CJP-Whitt/Spot_Welder/README.md

# DIY Spot Welder
DIY spot welder from old microwave for making Li-ion 18650 packs with nickel strips.
Uses bluetooth communication in custom Android app to adjust welding parameters.

Video of welder in use (plus how strong welds can be): https://www.youtube.com/watch?v=DYY4uMhj9es&ab_channel=whittyman  
Photos of build progression (Google photos): https://photos.app.goo.gl/j9NsPbFjYHL5vnTS6  

# Spot Welder Controller Android Application
Android App for changing welding parameters to get ideal weld
APK Download Link V1.1 --> https://drive.google.com/file/d/1LjHpt89rQLZouo0MwVBHZ62kARO4WaJr/view?usp=sharing

# Disclaimer!
Do your research! I do not take responsibility for any issues you may encounter during your build if you attempt to make a spot welder. It is difficult and there are many roadblocks you must engineer your way through. Learning comes through failure and troubleshooting so get used to it now if you plan on doing more projects in the future.

*Project relies on SPI flash chip on board the Express M0 Board, if you want to use a different board you may have to adjust code*

# Sections
- [Components](#components)  
- [Spot Welder Build Progression](#build-progression)  
- [Spot Welder Settings App](#app-details)  
- [Arduino Firmware](#arduino-details)  

# Finished Project
### _Max Current Output: ~550 Amps, Max Current Draw: ~35 Amps, Secondary Coil Output: ~7 Volts, Primary Coil Resistance: 0.4 Ohms_

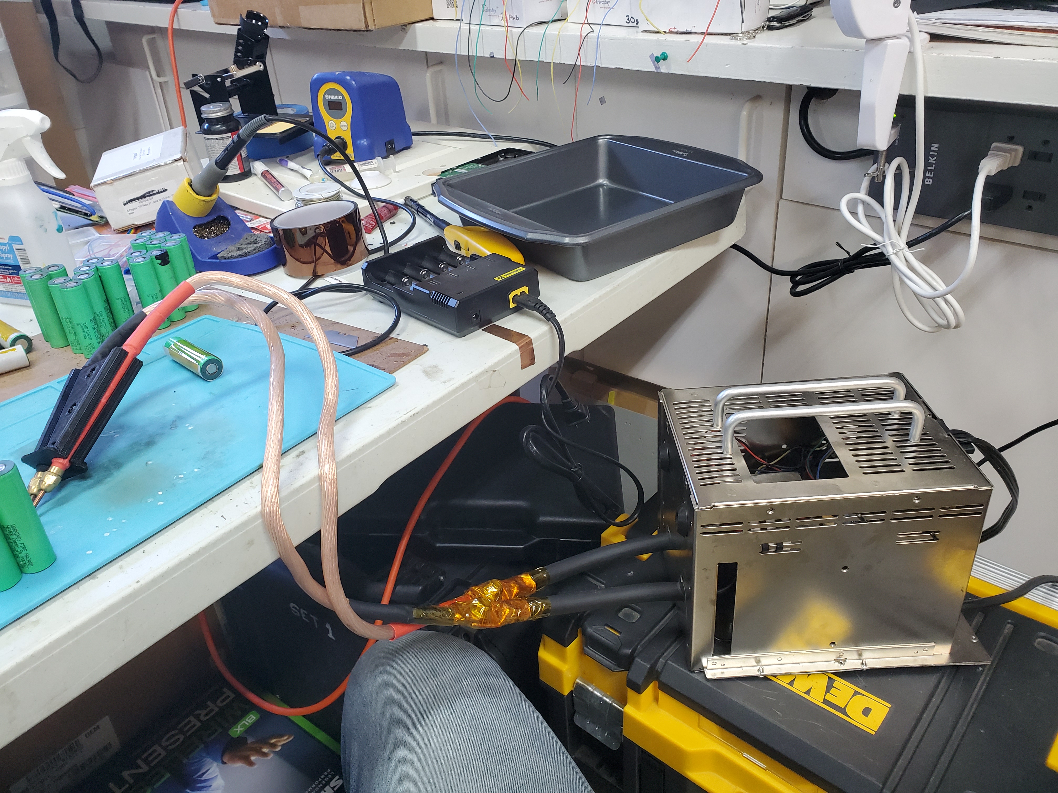
[picture p1: SpotWelder_Photos/firstUse.jpg]
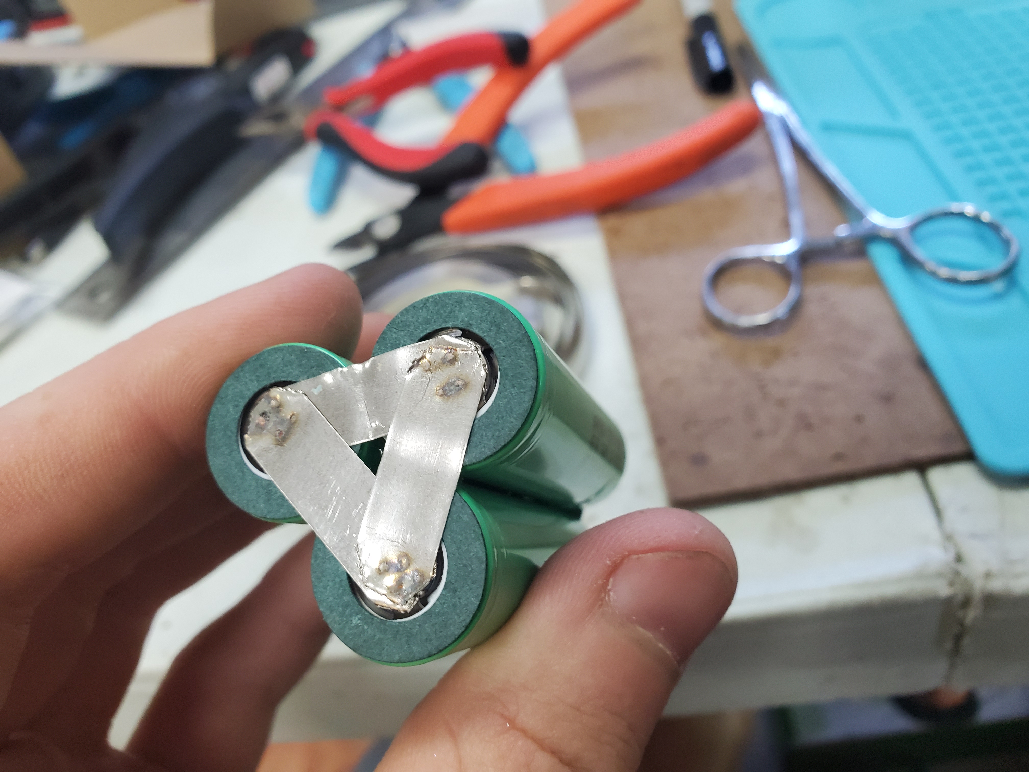
[picture p2: SpotWelder_Photos/batteryExample.jpg]
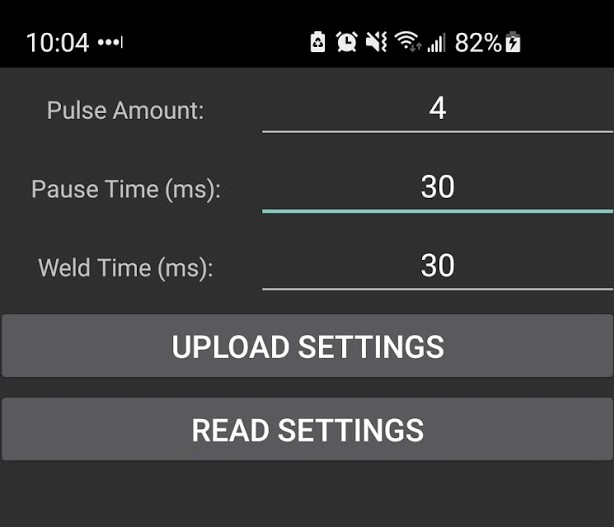
[picture p3: SpotWelder_Photos/SpotWelder_AppSettings.jpg]


## Components
1.) AC relay: https://www.amazon.com/SSR-25-DC-AC-Solid-State-Relay/dp/B07FVR37QN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  
2.) Adafruit ItsyBitsy Express M0: https://www.adafruit.com/product/3727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  
3.) Foot pedal switch:  https://www.amazon.com/URBEST-Momentary-Industrial-Anti-skid-Surface/dp/B01LXTEQ1C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  
4.) HC-05 bluetooth module: https://www.amazon.com/Wireless-Bluetooth-Receiver-Transceiver-Transmitter/dp/B01MQKX7VP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  
5.) Wall outlet usb charger (basically any work...make sure output voltage isn't too high)
6.) Microwave transformer (From my experience 750W is not enough, try to find at least a 1000W one)  
7.) Welding cable 2/0GA  
8.) Outlet plug and cable (preferably with ground wire, take from microwave you disassemble)  
9.) Welding tips: https://www.amazon.com/gp/product/B085FTFLMQ/ref=ppx_yo_dt_b_asin_title_o04_s00?ie=UTF8&psc=1  
10.) Crimp on terminal lugs  
11.) Some kind of insulation for electrical connections  

## Build Progression

### Step One: Getting the right transformer
You need a big enough transformer for this to work. My first transformer I got of 750W wasn’t powerful enough. I got another one from an old microwave that was 1000W and that one was perfect. Here you can see them side by side. Bigger one is 1000W.

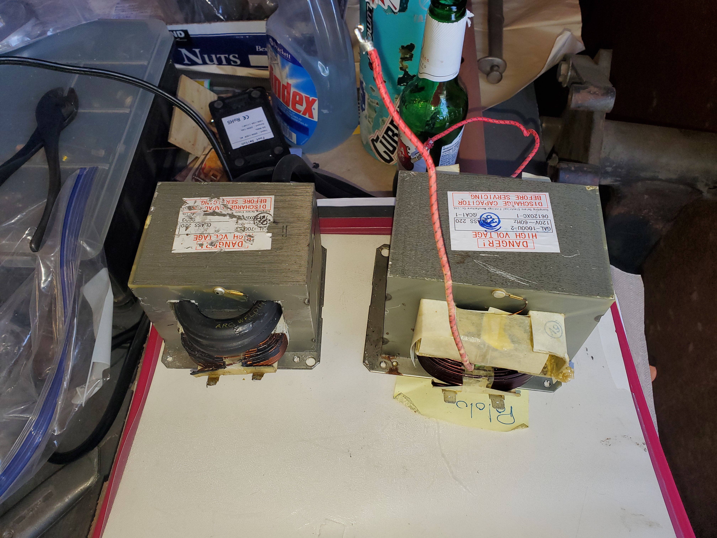
[picture p4: SpotWelder_Photos/20200905_143613.jpg]
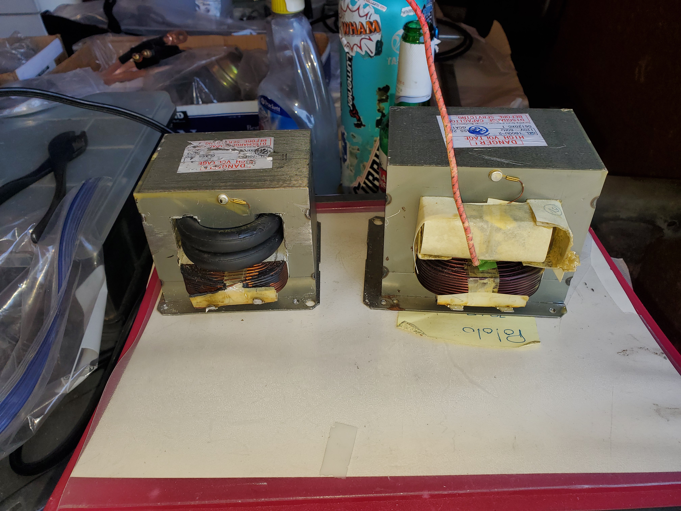
[picture p5: SpotWelder_Photos/20200905_143610.jpg]


### Step Two: Rewinding the secondary coil
To get the right output current from this transformer for spot welding (high current) I had to change the secondary coil. I cut the transformer core at the seams and took out the finer wound coil and replaced it with very very thick gauge wire, it's actually welding cable. Then I rewelded the seams and have a complete high current transformer capable of 550 Amps.

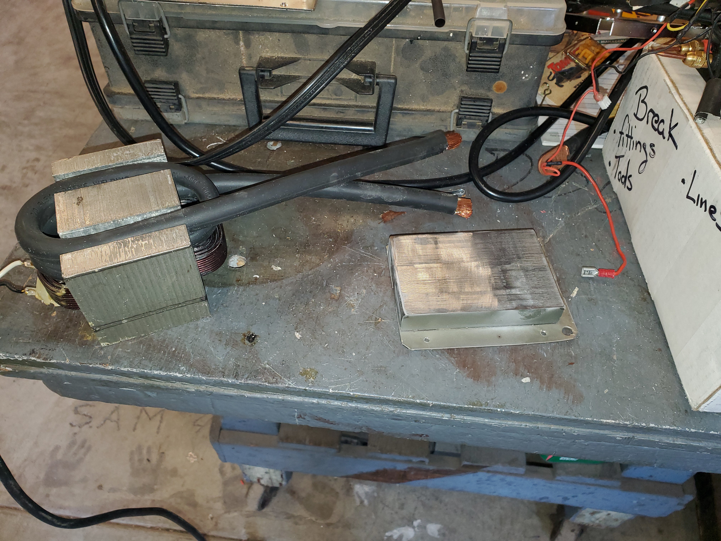
[picture p6: SpotWelder_Photos/20200912_140432.jpg]
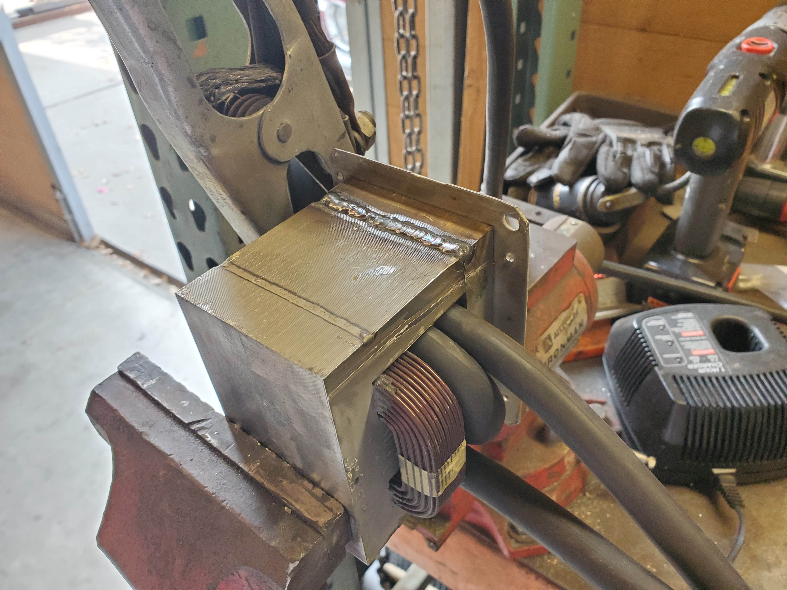
[picture p7: SpotWelder_Photos/20200912_144256.jpg]


### Step Three: Getting a shell
For the shell I used an old power supply casing for a server power supply. It worked quite nicely. I would definitely suggest having a metal casing so you can ground it and not have to worry about being electrocuted.

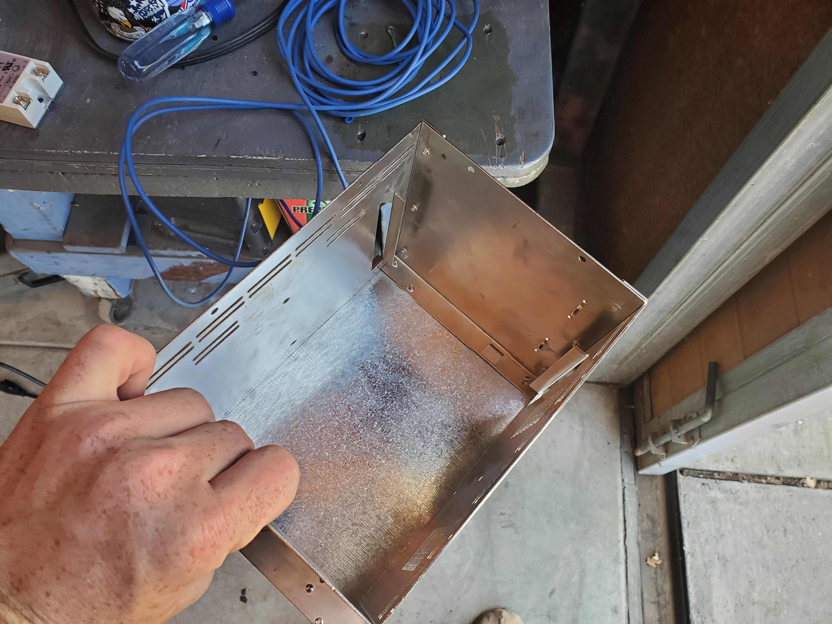
[picture p8: SpotWelder_Photos/20200725_133812.jpg]


### Step Four: Wiring and completion
Here is a amatuer wiring diagram I created along with an image of the inside of the finished Spot Welder.

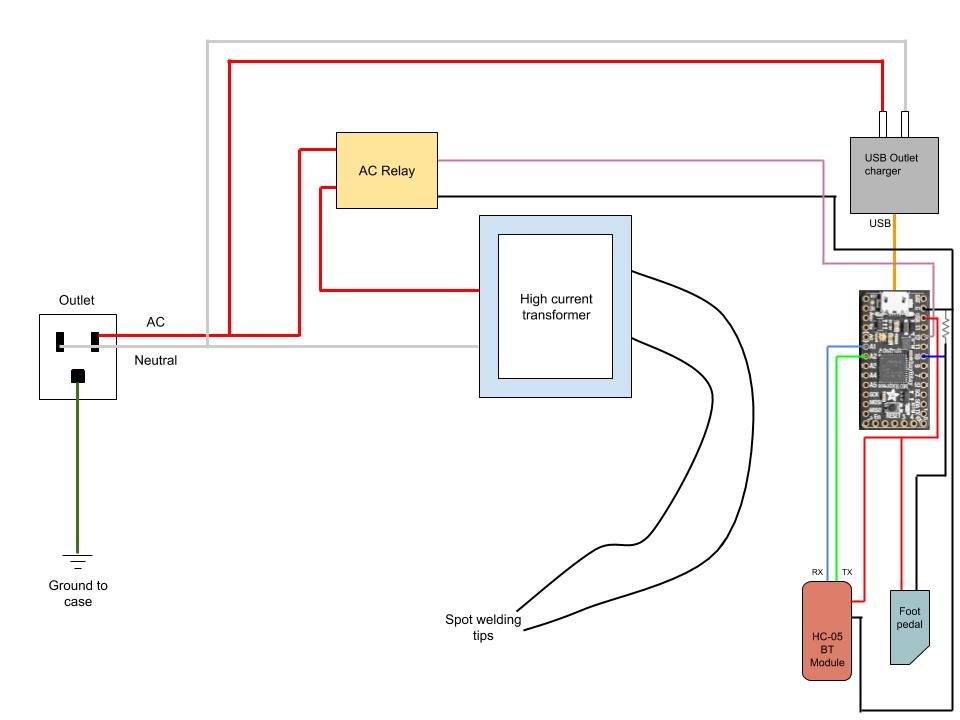
[picture p9: SpotWelder_Photos/Wiring Diagram Final.jpg]


## App Details
The app connects to the BLE module connected to the arduino. It changes settings that are saved on board the arduino. Or it can load saved settings from the arduino (happens automatically on startup).

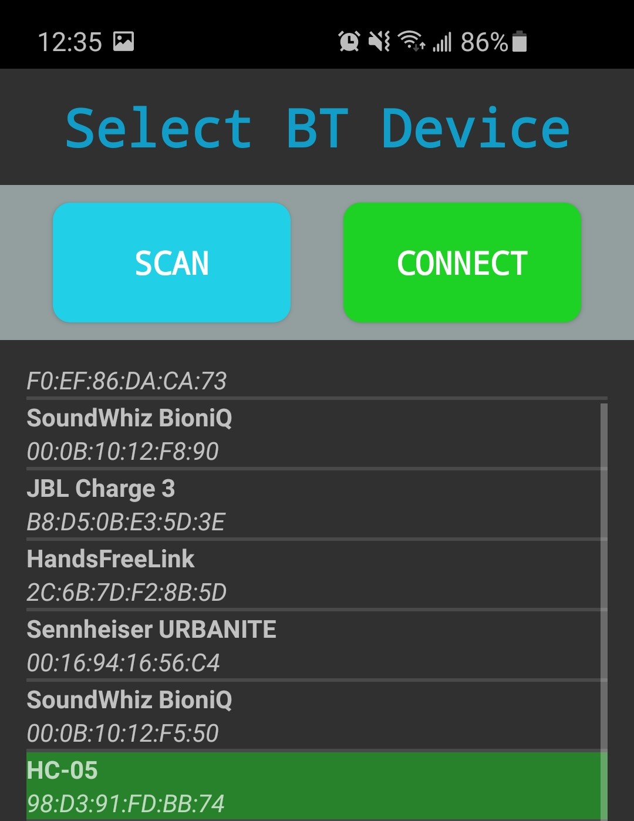
[picture p10: SpotWelder_Photos/spotWelderApp (2).jpg]


## Arduino Details
The arduino firmware controls the switch for the transformer based on the foot pedal and burst weld settings (3 Welding Settings), and it also holds the stored settings from previous use. The welding process has 3 parts, how many pulses to weld with, how long to weld for each pulse and the pause in between pulses.

Warning!:
- The "SPIMemory" library has some bugged verions so I would suggest using the 3.3.0 version. Otherwise the settings may not save on the flash chip.
