CJP-Whitt/Spot_Welder/SpotWelder_Photos/20200725_133807.jpg

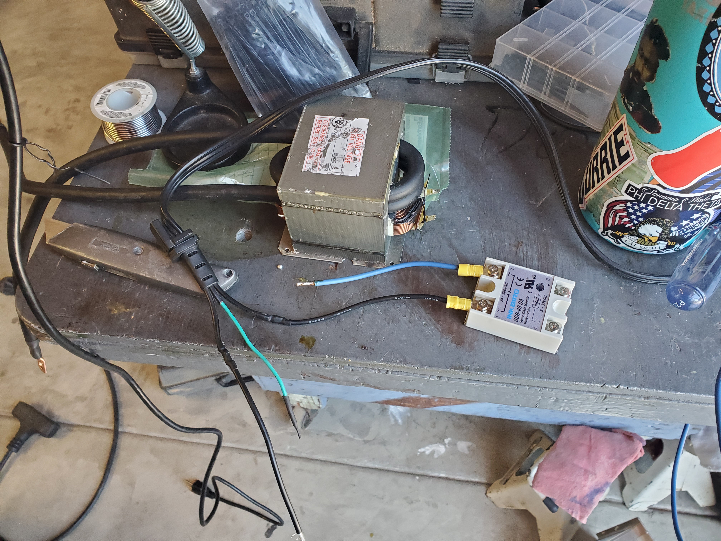
SpotWelder_Photos/20200725_133807.jpg
