CJP-Whitt/Spot_Welder/SpotWelder_Photos/20200725_143858.jpg

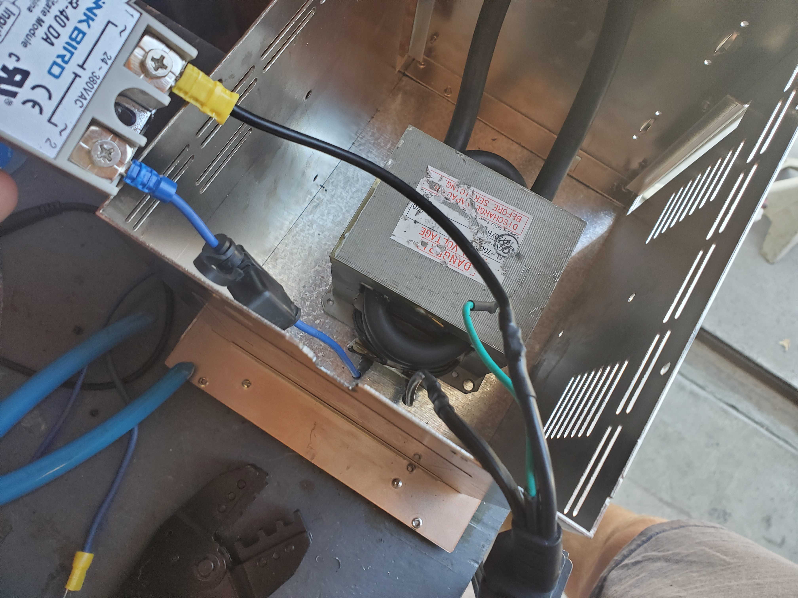
SpotWelder_Photos/20200725_143858.jpg
