CJP-Whitt/Spot_Welder/SpotWelder_Photos/20200831_170752.jpg

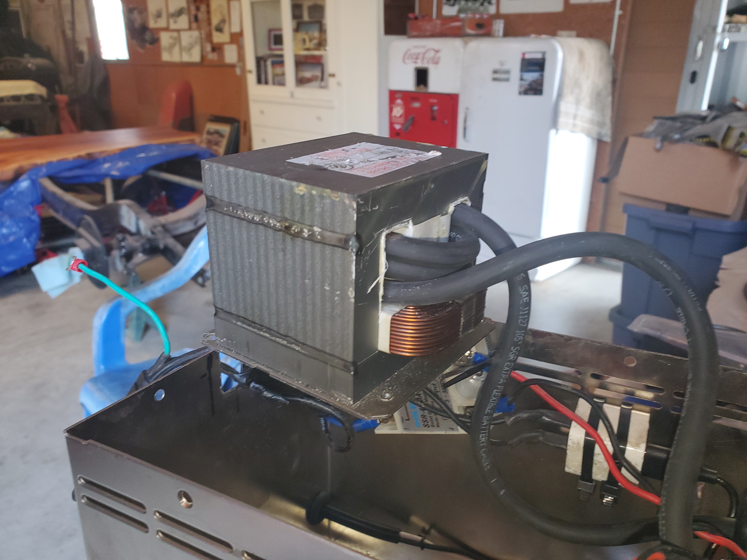
SpotWelder_Photos/20200831_170752.jpg
