CJP-Whitt/Spot_Welder/SpotWelder_Photos/20200831_170756.jpg

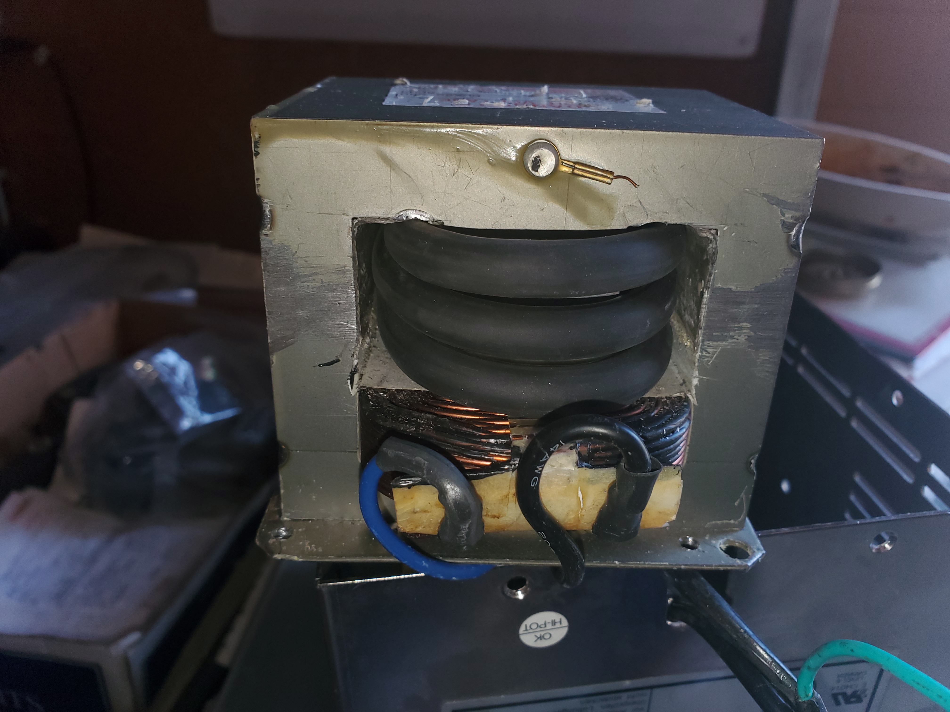
SpotWelder_Photos/20200831_170756.jpg
