CJP-Whitt/Spot_Welder/SpotWelder_Photos/20200831_174544.jpg

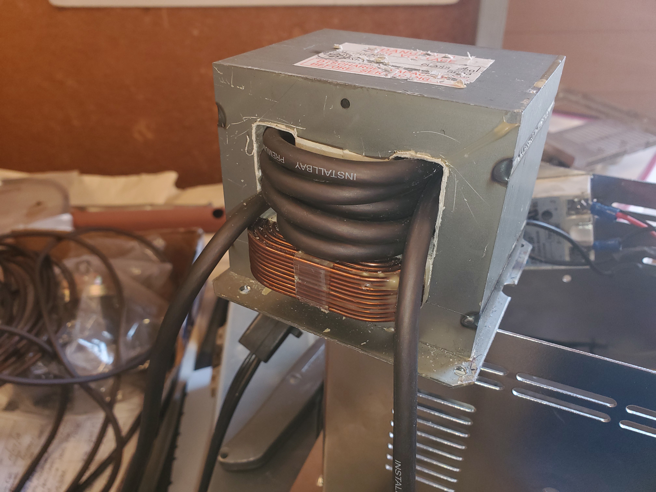
SpotWelder_Photos/20200831_174544.jpg
