CJP-Whitt/Spot_Welder/SpotWelder_Photos/20200831_174548.jpg

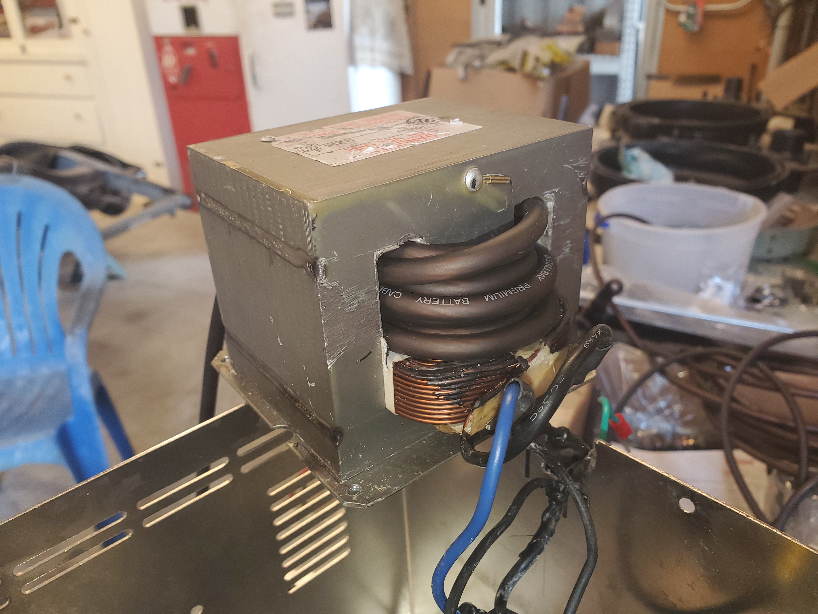
SpotWelder_Photos/20200831_174548.jpg
