CJP-Whitt/Spot_Welder/SpotWelder_Photos/20200831_174553.jpg

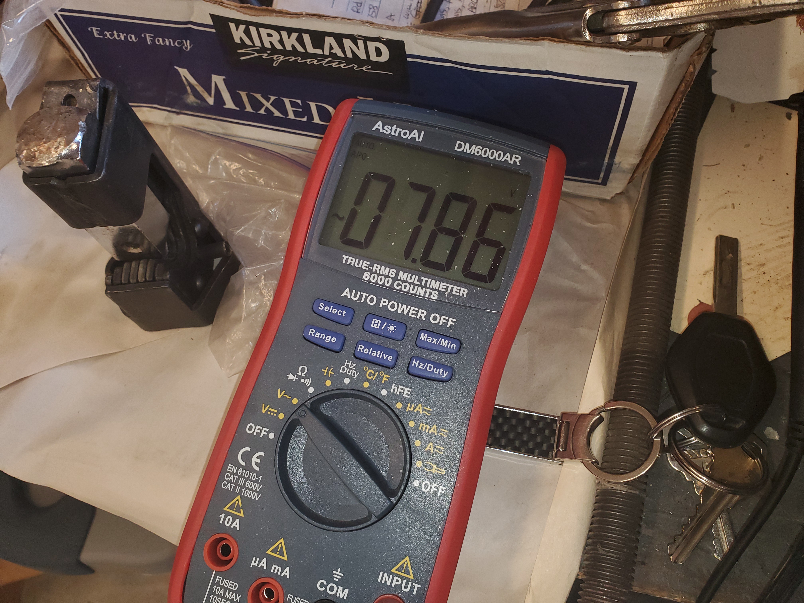
SpotWelder_Photos/20200831_174553.jpg
