CJP-Whitt/Spot_Welder/SpotWelder_Photos/20200901_213751.jpg

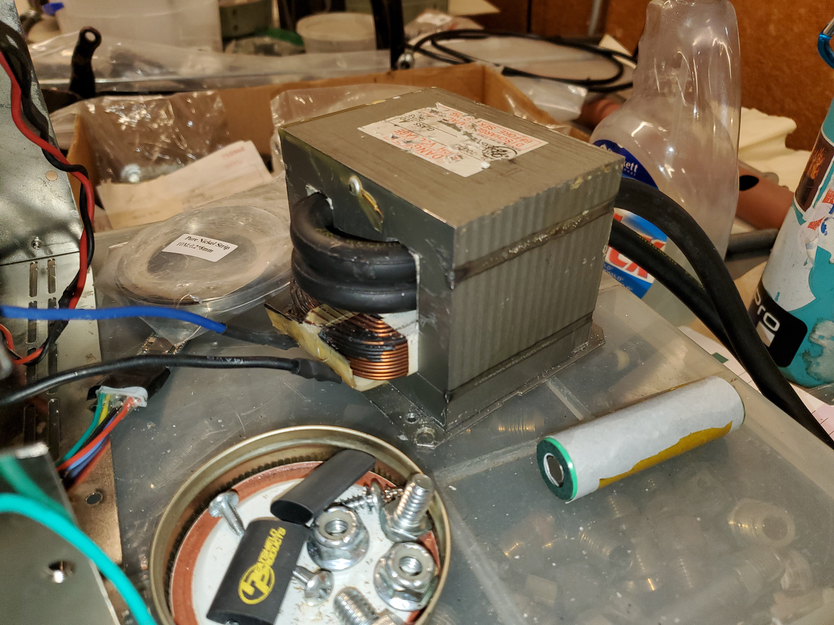
SpotWelder_Photos/20200901_213751.jpg
