CJP-Whitt/Spot_Welder/SpotWelder_Photos/20200912_140439.jpg

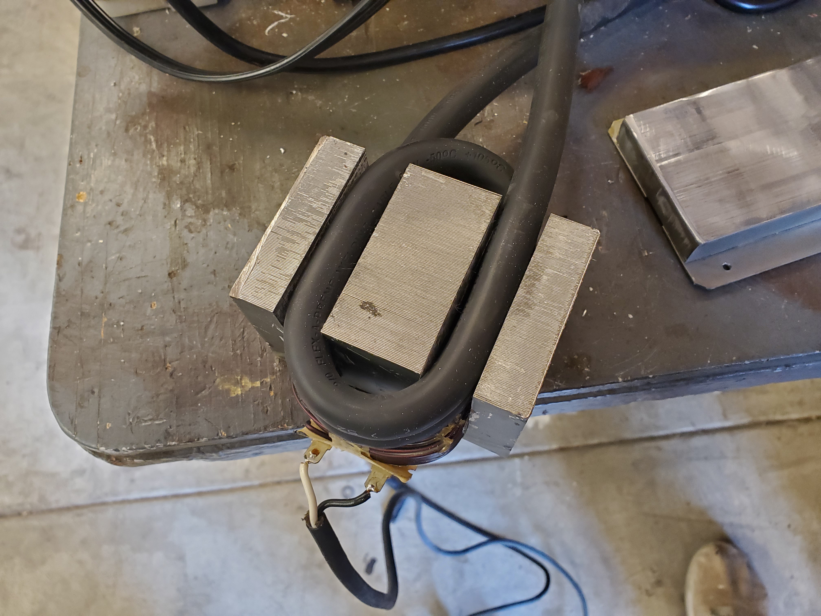
SpotWelder_Photos/20200912_140439.jpg
