CJP-Whitt/Spot_Welder/SpotWelder_Photos/20200912_143429.jpg

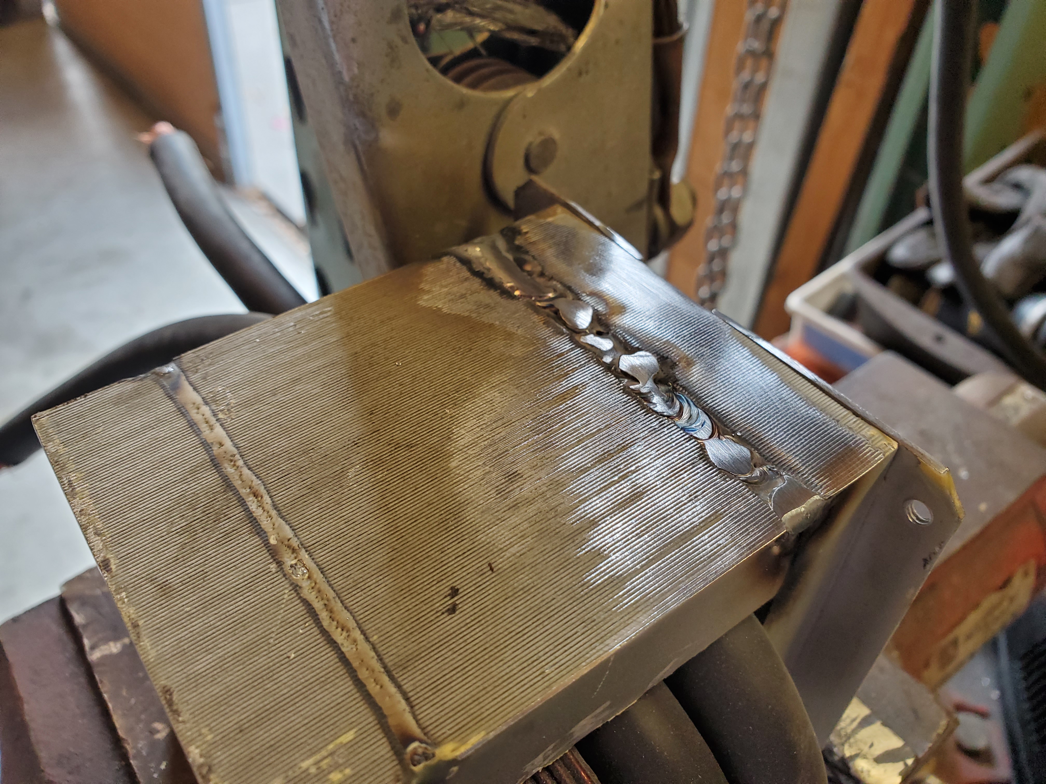
SpotWelder_Photos/20200912_143429.jpg
