CJP-Whitt/Spot_Welder/SpotWelder_Photos/20200912_144251.jpg

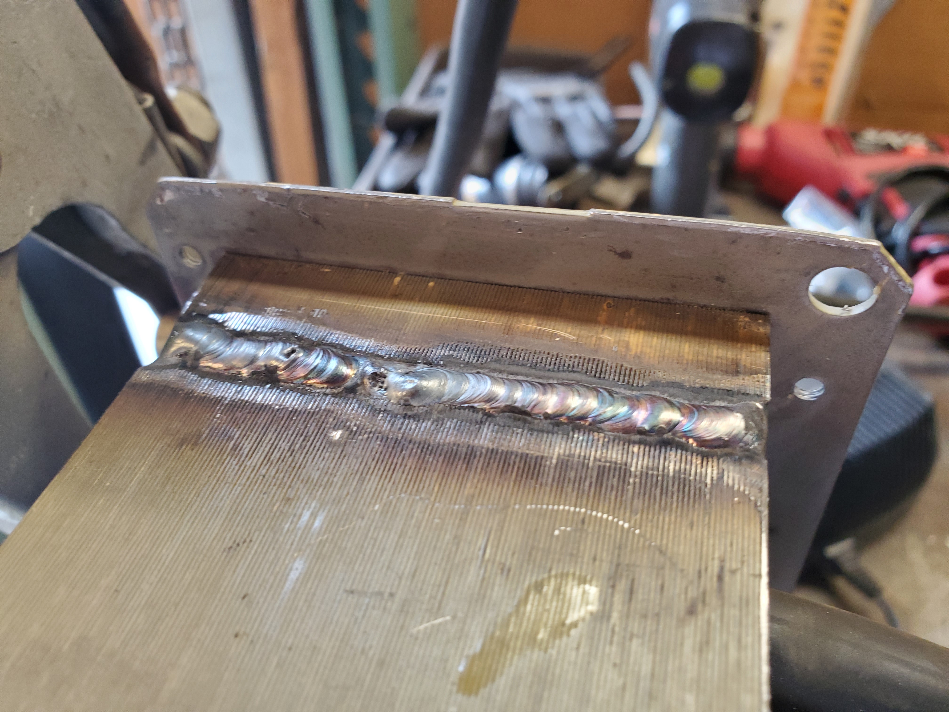
SpotWelder_Photos/20200912_144251.jpg
