CJP-Whitt/Spot_Welder/SpotWelder_Photos/20200912_162733.jpg

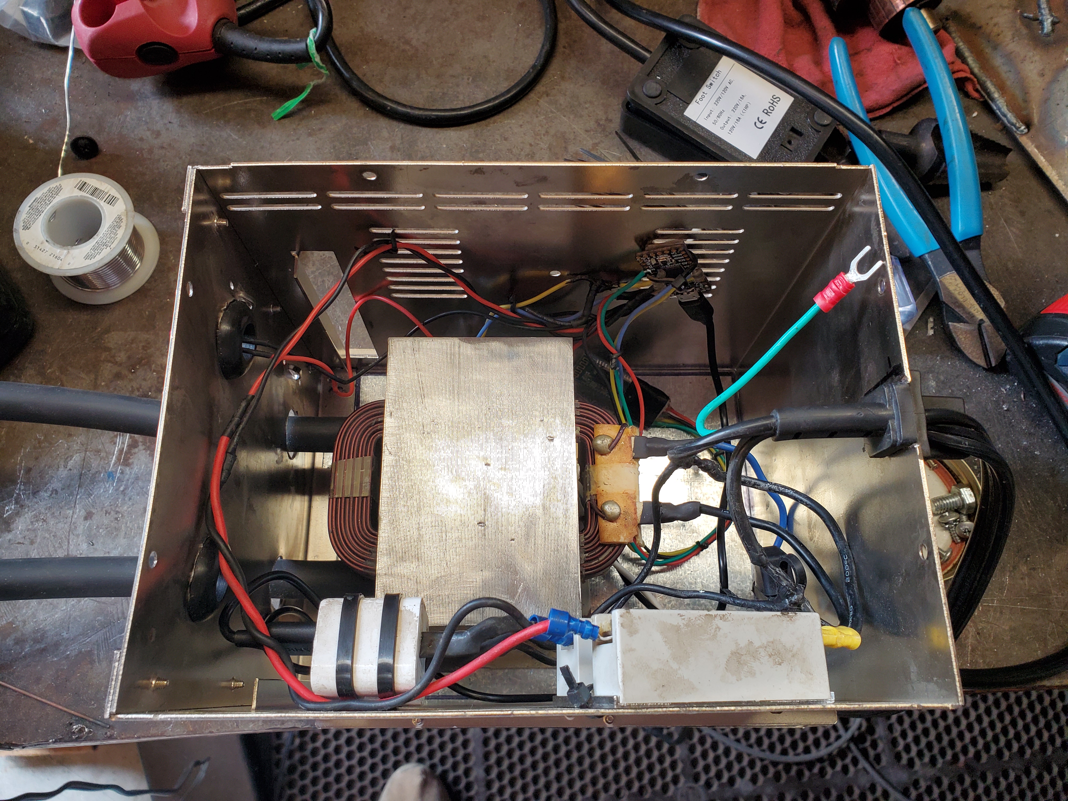
SpotWelder_Photos/20200912_162733.jpg
