CJP-Whitt/Spot_Welder/SpotWelder_Photos/20200917_165559.jpg

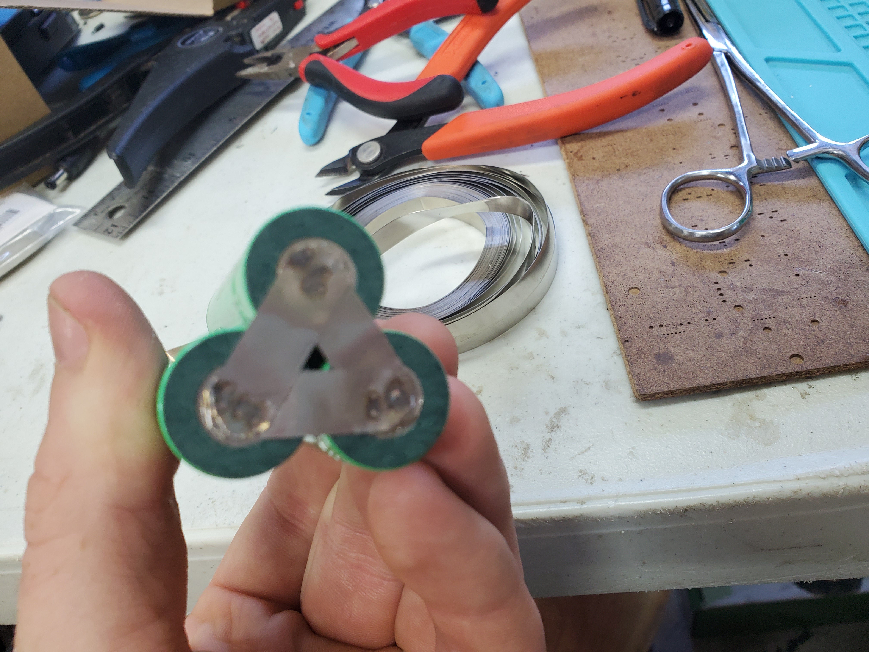
SpotWelder_Photos/20200917_165559.jpg
