CJP-Whitt/Spot_Welder/SpotWelder_Photos/spotWelderApp.jpg

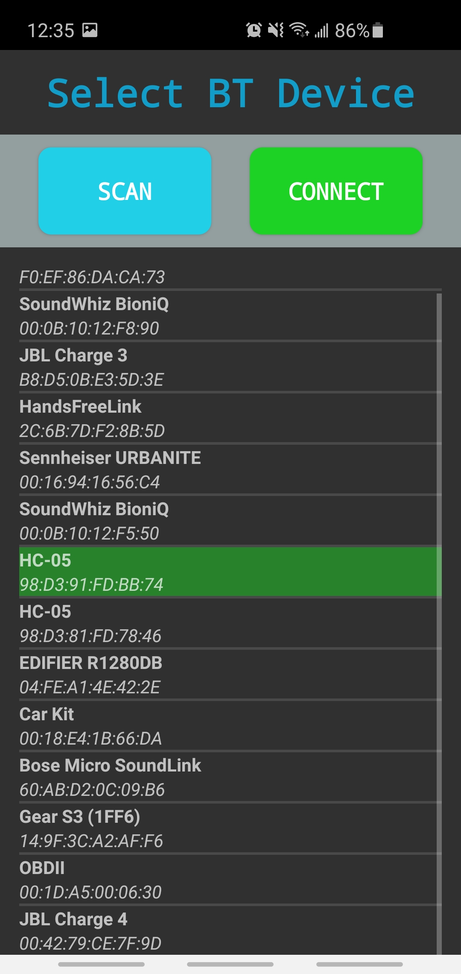
SpotWelder_Photos/spotWelderApp.jpg
