CJP-Whitt/Spot_Welder/(commit log)

2020-08-02 Working list of bonded devices
2020-08-04 List devices, onClickItem
2020-08-06 BT Led test working
2021-01-03 Added Spot Welder photos
2021-01-07 Added arduino firmware for controlling welds
2021-03-16 Updated app and arduino firmware to have multipel pulses
2021-03-17 Fixed bug where settings were not saving on flash chip
    [Spot_Welder.ino]
2021-03-18 Quick bug fix, got rid of wait for serial
    [Spot_Welder.ino]
