CJP-Whitt/Spot_Welder/SpotWelder_Photos/20200831_171723.jpg

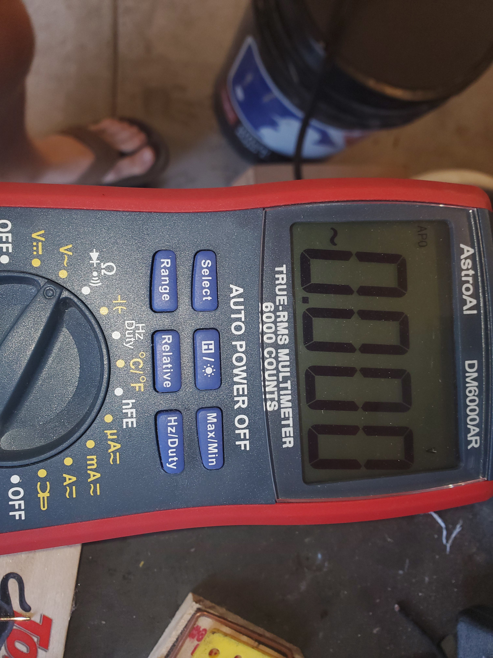
SpotWelder_Photos/20200831_171723.jpg
