CJP-Whitt/Spot_Welder/SpotWelder_Photos/20200831_171725.jpg

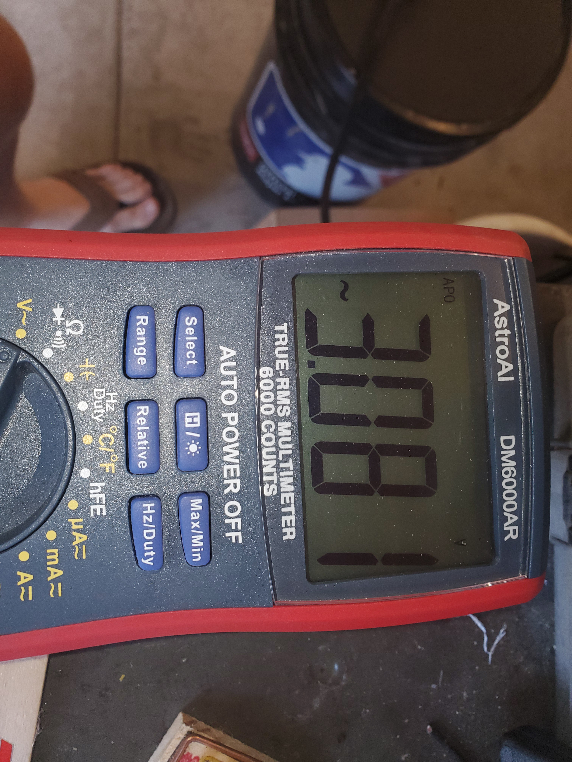
SpotWelder_Photos/20200831_171725.jpg
