CJP-Whitt/Spot_Welder/SpotWelder_Photos/20200905_143752.jpg

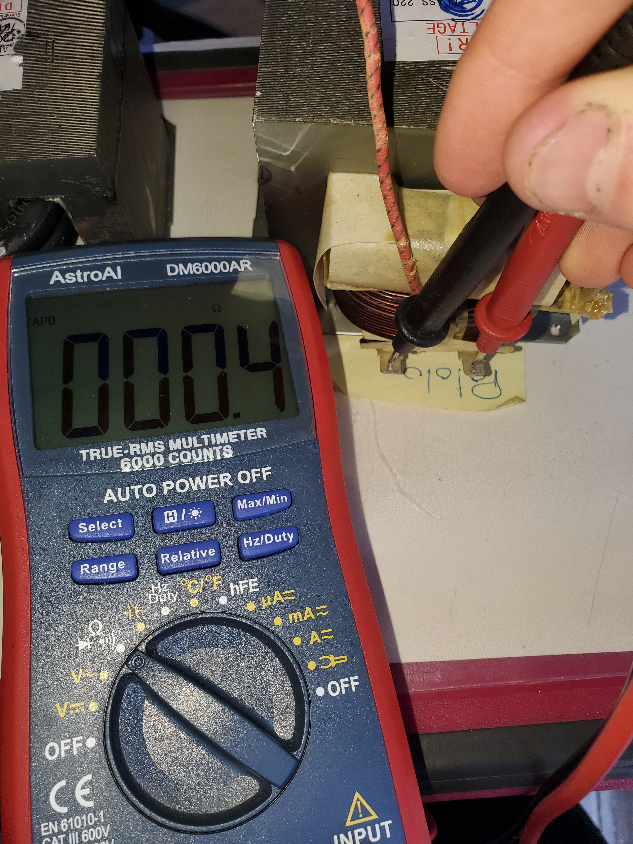
SpotWelder_Photos/20200905_143752.jpg
