CJP-Whitt/Spot_Welder/SpotWelder_Photos/20200905_143907.jpg

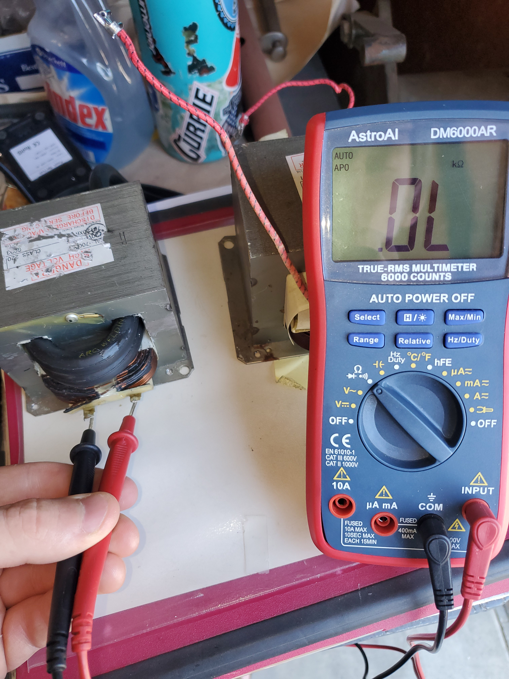
SpotWelder_Photos/20200905_143907.jpg
