CJP-Whitt/Spot_Welder/SpotWelder_Photos/20200912_144708.jpg

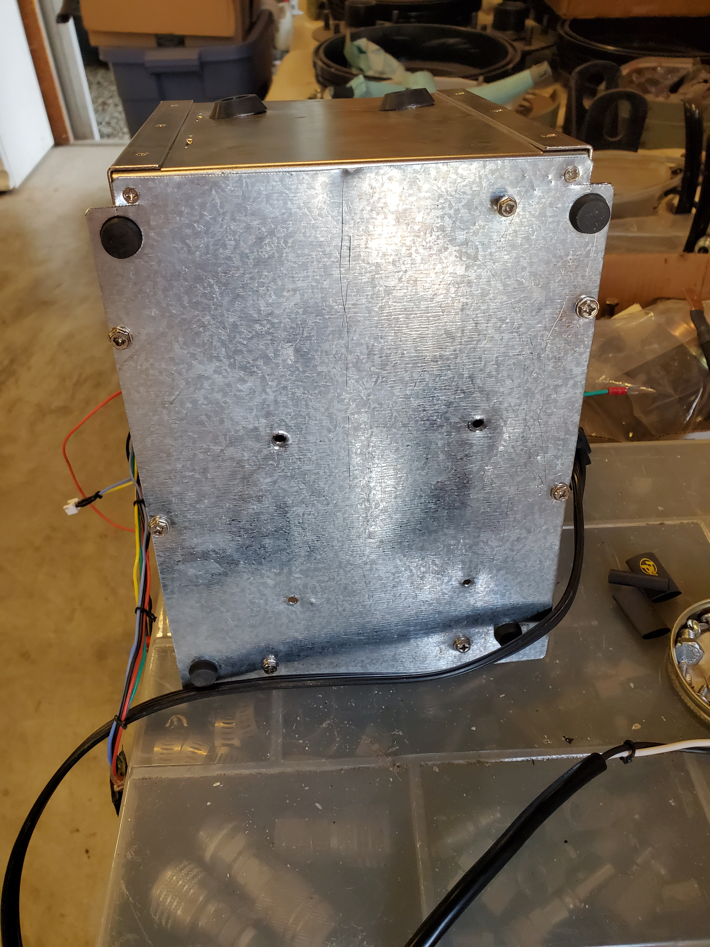
SpotWelder_Photos/20200912_144708.jpg
